hannagentai-stack/DoAn2_Traffic_Light_FPGA/docs/Danh_Sach_Chan_IO_FPGA_Cyclone_IV_Anode_Chung.docx

TRƯỜNG ĐẠI HỌC - KHOA ĐIỆN - ĐIỆN TỬ / BỘ MÔN KỸ THUẬT MÁY TÍNH

BẢNG TRA CỨU & DANH SÁCH GÁN CHÂN I/O PHẦN CỨNG FPGA

Phiên bản: ANODE CHUNG (Common Anode - 5621AH) - Kit Cyclone IV EP4CE6E22C8N & DE2-115

# 1. Thông Số Kỹ Thuật Bo Mạch FPGA Mục Tiêu

Dự án được thiết kế, tổng hợp và nạp thực tế trên bo mạch lõi FPGA giá rẻ phổ biến Altera / Intel Cyclone IV E EP4CE6E22C8N (kit lõi đen / Mini Core Board) và tương thích hoàn toàn về kiến trúc với dòng bo thí nghiệm Terasic DE2-115 (EP4CE115F29C7). Dưới đây là thông số phần cứng cốt lõi:

Thành Phần Phần Cứng | Thông Số / Mã Chip | Đặc Điểm Kỹ Thuật
Chip FPGA Chính | Altera / Intel Cyclone IV E EP4CE6E22C8N | Đóng gói QFP-144 chân, 6.272 Logic Elements, 392 Kbits RAM, 2 khối PLL.
Nguồn Cấp Hệ Thống | 5V DC qua cổng Type-C hoặc Header | Hạ áp bởi IC AMS1117 ra 3.3V (VCCIO cho các I/O Banks) và 1.2V (VCCINT cho lõi FPGA).
Xung Nhịp Master Clock | 50.000 MHz (Thạch anh tích hợp) | Nối vào chân PIN_24 (CLK0). Chu kỳ T = 20 ns, độ lệch pha ổn định < 0.1%.
Xung Nhịp Phụ (nếu có) | 27.000 MHz (Thạch anh thứ 2) | Nối vào chân PIN_90 / PIN_91 (dùng cho các ứng dụng Video/VGA nếu cần).
Bộ Nhớ Flash Nạp Code | EPCS4N / EPCS16 (SPI Flash) | Nối qua bus Active Serial (AS). Lưu file .jic để mạch chạy vĩnh viễn không mất code khi mất điện.
Giao Tiếp Nạp JTAG | Chuẩn Header 10-pin 2.54mm | Kết nối cáp USB-Blaster (TCK=16, TMS=18, TDO=20, TDI=17) nạp file .sof trực tiếp vào RAM.
Giao Tiếp UART / Serial | Chip USB-UART CH340 / Type-C | Nối sẵn vào chân PIN_10 (TXD) và PIN_23 (RXD), truyền dữ liệu lên máy tính PC.

# 2. Danh Sách Các Chân Cứng ONBOARD (Kiểm Chứng 100% Trên Bo)

Đây là danh sách toàn bộ các chân I/O đã được hàn cố định vào linh kiện trên bo mạch Cyclone IV EP4CE6E22C8N. Khi thiết kế mạch ngoài, cần nắm rõ để tránh xung đột phần cứng:

Chân FPGA | Linh Kiện Onboard | Chuẩn / Mức Logic | Ghi Chú & Kiểm Chứng Thực Tế
PIN_24 | Thạch anh 50 MHz | 3.3V LVTTL | In chữ '50M 24/25' trên PCB. Chân Clock toàn cục GCLK0. (PIN_25 là kênh dự phòng GCLK1).
PIN_1 | LED 1 Onboard (D1) | Active-Low (0 = Sáng) | In số '1' cạnh JTAG. Đã kiểm chứng sáng chớp tắt thành công.
PIN_2 | LED 2 Onboard (D2) | Active-Low (0 = Sáng) | In số '2' cạnh JTAG. Đã kiểm chứng sáng chớp tắt thành công.
PIN_3 | LED 3 Onboard (D3) | Active-Low (0 = Sáng) | In số '3' cạnh JTAG. Đã kiểm chứng sáng chớp tắt thành công.
PIN_7 | LED 4 Onboard (D4) | Active-Low (0 = Sáng) | In số '7' cạnh JTAG. Đã kiểm chứng sáng chớp tắt thành công.
PIN_11 | LED 5 Onboard (D5) | Active-Low (0 = Sáng) | In số '11' cạnh JTAG. Đã kiểm chứng sáng chớp tắt thành công.
PIN_88 | Nút Nhấn Reset | Active-Low (0 = Nhấn) | Nút bấm Reset hệ thống. Nối trở kéo lên 10k lên 3.3V trên bo.
PIN_73 | Nút Nhấn KEY 1 | Active-Low (0 = Nhấn) | In số '73' trên PCB cạnh hàng phím. Có thể dùng làm nút khẩn cấp A.
PIN_80 | Nút Nhấn KEY 2 | Active-Low (0 = Nhấn) | In số '80' trên PCB cạnh hàng phím. Có thể dùng làm nút khẩn cấp B.
PIN_89 | Nút Nhấn KEY 3 | Active-Low (0 = Nhấn) | In số '89' trên PCB. Có thể dùng làm công tắc chuyển chế độ.
PIN_114 | Nút Nhấn KEY 4 | Active-Low (0 = Nhấn) | In số '114' trên PCB. Nút nhấn người dùng đa năng.
PIN_23 | UART RX (Từ CH340) | 3.3V LVTTL | Nhận tín hiệu Serial từ máy tính qua cáp Type-C. KHÔNG ĐƯỢC DÙNG LÀM CLOCK!
PIN_10 | UART TX (Đến CH340) | 3.3V LVTTL | Truyền tín hiệu Serial từ FPGA lên máy tính qua cáp Type-C.
PIN_74 | Flash EPCS4N DATA0 | 3.3V LVTTL | Chân dữ liệu vào Flash SPI nạp vĩnh viễn.
PIN_75 | Flash EPCS4N DCLK | 3.3V LVTTL | Chân xung nhịp SPI cho Flash.
PIN_84 | Flash EPCS4N ASDI | 3.3V LVTTL | Chân dữ liệu ra Flash SPI.
PIN_87 | Flash EPCS4N nCS | 3.3V LVTTL | Chân chọn chip Flash Active-Low.

CẢNH BÁO QUAN TRỌNG VỀ XUNG CLOCK: Cực kỳ lưu ý rằng chân PIN_23 trên bo này được nối cố định với chip nạp UART CH340 (chân RX nhận dữ liệu từ USB), KHÔNG PHẢI là chân Clock 50MHz như một số bo kit Altera cũ khác. Chân thạch anh 50MHz chuẩn trên bo này bắt buộc phải là PIN_24 (CLK0)!

# 3. Bảng Gán Chân Chi Tiết Cho Dự Án Đèn Giao Thông (Top-Level Anode Chung)

Bảng dưới đây quy định toàn bộ 30 chân FPGA (gồm 1 chân Clock toàn cục 50MHz PIN_24 và 29 tín hiệu I/O ngoại vi) của thiết kế Top-Level (traffic_light_top.vhd) cho LED 7 đoạn Anode chung kèm IC đệm ULN2803A, kèm theo chân FPGA và vị trí cắm trên các hàng rào GPIO Header:

Tên Tín Hiệu (Port) | Hướng | Chân FPGA | Chuẩn Logic | Mức Kích Hoạt | Chức Năng & Vị Trí Kết Nối
CLOCK_50 | IN | PIN_24 | 3.3V LVTTL | Xung vuông | Thạch anh 50MHz tích hợp trên bo (GCLK0).
LEDG[0] | OUT | PIN_39 | 3.3V LVTTL | Active-High (1) | Đèn XANH Làn A (xanh_a trên Altium).
LEDR[0] | OUT | PIN_43 | 3.3V LVTTL | Active-High (1) | Đèn VÀNG Làn A (vang_a trên Altium).
LEDR[1] | OUT | PIN_46 | 3.3V LVTTL | Active-High (1) | Đèn ĐỎ Làn A (do_a trên Altium).
LEDG[1] | OUT | PIN_50 | 3.3V LVTTL | Active-High (1) | Đèn XANH Làn B (xanh_b trên Altium).
LEDR[2] | OUT | PIN_52 | 3.3V LVTTL | Active-High (1) | Đèn VÀNG Làn B (vang_b trên Altium).
LEDR[3] | OUT | PIN_54 | 3.3V LVTTL | Active-High (1) | Đèn ĐỎ Làn B (do_b trên Altium).
KEY[0] | IN | PIN_58 | 3.3V LVTTL | Active-Low (0) | Nút Reset toàn hệ thống (KEY0 trên Altium).
KEY[1] | IN | PIN_60 | 3.3V LVTTL | Active-Low (0) | Nút Khẩn cấp Làn A (KEY1 trên Altium).
KEY[2] | IN | PIN_65 | 3.3V LVTTL | Active-Low (0) | Nút Khẩn cấp Làn B (KEY2 trên Altium).
SW[0] | IN | PIN_67 | 3.3V LVTTL | Active-Low (0) | Chân 1 công tắc 3 nấc: Chế độ Ban đêm SW0 (Chớp vàng 1Hz).
SW[1] | IN | PIN_69 | 3.3V LVTTL | Active-Low (0) | Chân 3 công tắc 3 nấc: Chế độ Tạm dừng Pause SW1.
HEX_A_SEG[0] | OUT | PIN_129 | 3.3V LVTTL | Active-High (1) | Thanh đoạn a_a -> In 1B ULN2803A -> Qua trở R1 vào Chân 1 LED A.
HEX_A_SEG[1] | OUT | PIN_133 | 3.3V LVTTL | Active-High (1) | Thanh đoạn b_a -> In 2B ULN2803A -> Qua trở R2 vào Chân 2 LED A.
HEX_A_SEG[2] | OUT | PIN_136 | 3.3V LVTTL | Active-High (1) | Thanh đoạn c_a -> In 3B ULN2803A -> Qua trở R3 vào Chân 3 LED A.
HEX_A_SEG[3] | OUT | PIN_138 | 3.3V LVTTL | Active-High (1) | Thanh đoạn d_a -> In 4B ULN2803A -> Qua trở R4 vào Chân 4 LED A.
HEX_A_SEG[4] | OUT | PIN_142 | 3.3V LVTTL | Active-High (1) | Thanh đoạn e_a -> In 5B ULN2803A -> Qua trở R5 vào Chân 5 LED A.
HEX_A_SEG[5] | OUT | PIN_144 | 3.3V LVTTL | Active-High (1) | Thanh đoạn f_a -> In 6B ULN2803A -> Qua trở R6 vào Chân 6 LED A.
HEX_A_SEG[6] | OUT | PIN_143 | 3.3V LVTTL | Active-High (1) | Thanh đoạn g_a -> In 7B ULN2803A -> Qua trở R7 vào Chân 7 LED A.
HEX_A_DIG[0] | OUT | PIN_137 | 3.3V LVTTL | Active-High (1) | Chân chọn dig2_a (Đơn vị) -> Chân 9 Socket LED Làn A.
HEX_A_DIG[1] | OUT | PIN_141 | 3.3V LVTTL | Active-High (1) | Chân chọn dig1_a (Hàng chục) -> Chân 8 Socket LED Làn A.
HEX_B_SEG[0] | OUT | PIN_111 | 3.3V LVTTL | Active-High (1) | Thanh đoạn a_b -> In 1B ULN2803A -> Qua trở R8 vào Chân 1 LED B.
HEX_B_SEG[1] | OUT | PIN_113 | 3.3V LVTTL | Active-High (1) | Thanh đoạn b_b -> In 2B ULN2803A -> Qua trở R9 vào Chân 2 LED B.
HEX_B_SEG[2] | OUT | PIN_119 | 3.3V LVTTL | Active-High (1) | Thanh đoạn c_b -> In 3B ULN2803A -> Qua trở R10 vào Chân 3 LED B.
HEX_B_SEG[3] | OUT | PIN_121 | 3.3V LVTTL | Active-High (1) | Thanh đoạn d_b -> In 4B ULN2803A -> Qua trở R11 vào Chân 4 LED B.
HEX_B_SEG[4] | OUT | PIN_125 | 3.3V LVTTL | Active-High (1) | Thanh đoạn e_b -> In 5B ULN2803A -> Qua trở R12 vào Chân 5 LED B.
HEX_B_SEG[5] | OUT | PIN_127 | 3.3V LVTTL | Active-High (1) | Thanh đoạn f_b -> In 6B ULN2803A -> Qua trở R13 vào Chân 6 LED B.
HEX_B_SEG[6] | OUT | PIN_110 | 3.3V LVTTL | Active-High (1) | Thanh đoạn g_b -> In 7B ULN2803A -> Qua trở R14 vào Chân 7 LED B.
HEX_B_DIG[0] | OUT | PIN_112 | 3.3V LVTTL | Active-High (1) | Chân chọn dig2_b (Đơn vị) -> Chân 2 Socket LED Làn B.
HEX_B_DIG[1] | OUT | PIN_115 | 3.3V LVTTL | Active-High (1) | Chân chọn dig1_b (Hàng chục) -> Chân 1 Socket LED Làn B.

## 3.1. Bảng Hướng Dẫn Nối Dây Thực Tế Con LED 7 Đoạn Đôi 10 Chân Anode Chung Sang FPGA

Đây là bảng tra cứu trực tiếp theo thứ tự chân 1 đến 10 trên con LED 7 đoạn 2 chữ số Anode chung (5621AH / 3621AH, 10 chân) khi ghép nối với IC đệm dòng ULN2803G (DIP-18) để bảo vệ FPGA 100%:

SƠ ĐỒ BỐ TRÍ CHÂN THỰC TẾ (NHÌN TỪ MẶT TRƯỚC LED):
10 9 8 7 6
+--------------------------+
| A B D1 D2 F | <-- HÀNG CHÂN TRÊN
| |
| [DIG 1] [DIG 2] |
| (Hàng chục) (Đơn vị) |
| |
| C DP E D G | <-- HÀNG CHÂN DƯỚI
+--------------------------+
1 2 3 4 5

- IC ULN2803G đệm dòng cho 7 thanh đoạn: Chân FPGA phát mức '1' vào Input ULN2803G -> Output của ULN2803G kéo chân Cathode của thanh LED xuống GND -> LED SÁNG!
- 2 chân DIG1 (Chân 8) và DIG2 (Chân 7) là cực Dương chung (Anode), nối TRỰC TIẾP vào chân FPGA tương ứng (FPGA phát mức 1 cấp nguồn 3.3V).

Chân LED | Tên Đoạn | Nối Vào ULN2803G | Linh Kiện Kèm | FPGA Làn A | FPGA Làn B | Chức Năng & Vị Trí
Chân 1 | Thanh C | Out 3C (Chân 16) | Trở 330Ω | PIN_136 (In 3B) | PIN_119 (In 3B) | Thanh dọc dưới bên phải
Chân 2 | Dấu DP | Bỏ trống (Pin 11) | Không cắm | Để trống | Để trống | Dấu chấm lẻ (không dùng)
Chân 3 | Thanh E | Out 5C (Chân 14) | Trở 330Ω | PIN_142 (In 5B) | PIN_125 (In 5B) | Thanh dọc dưới bên trái
Chân 4 | Thanh D | Out 4C (Chân 15) | Trở 330Ω | PIN_138 (In 4B) | PIN_121 (In 4B) | Thanh ngang dưới đáy
Chân 5 | Thanh G | Out 7C (Chân 12) | Trở 330Ω | PIN_143 (In 7B) | PIN_110 (In 7B) | Thanh ngang ở chính giữa
Chân 6 | Thanh F | Out 6C (Chân 13) | Trở 330Ω | PIN_144 (In 6B) | PIN_127 (In 6B) | Thanh dọc trên bên trái
Chân 7 | DIG2 (Đơn vị) | Không qua ULN | Nối thẳng FPGA | PIN_137 | PIN_112 | Cực Dương chung Hàng đơn vị (3.3V)
Chân 8 | DIG1 (Chục) | Không qua ULN | Nối thẳng FPGA | PIN_141 | PIN_115 | Cực Dương chung Hàng chục (3.3V)
Chân 9 | Thanh B | Out 2C (Chân 17) | Trở 330Ω | PIN_133 (In 2B) | PIN_113 (In 2B) | Thanh dọc trên bên phải
Chân 10 | Thanh A | Out 1C (Chân 18) | Trở 330Ω | PIN_129 (In 1B) | PIN_111 (In 1B) | Thanh ngang trên đỉnh
ULN Pin 9 | GND IC ULN | Chân 9 (GND) | Dây nối GND | GND bo FPGA | GND bo FPGA | Cực Âm nguồn chung (BẮT BUỘC NỐI GND)
ULN Pin 10 | COM IC ULN | Chân 10 (COM) | Dây nối VCC | +3.3V / +5V | +3.3V / +5V | Chân diot dập xung (Nối lên nguồn 3.3V/5V)

## 3.2. Hướng Dẫn Chi Tiết Các Bước Cắm Dây Trên Breadboard (Board Test) Với IC UL2803G

Để cắm test mạch chạy mượt mà, không bị rối dây và đảm bảo an toàn tuyệt đối cho Kit FPGA Cyclone IV, bạn thực hiện cắm linh kiện trên Breadboard theo 4 bước chuẩn hóa sau:

BƯỚC 1: ĐẶT IC ULN2803A / ULN2803G VÀ CẤP NGUỒN
- Cắm 2 con IC ULN2803A (DIP-18) nằm ngang vắt qua rãnh giữa của Breadboard (IC1 cho Làn A, IC2 cho Làn B). Lưu ý khuyết tròn (chấm chỉ vị trí chân 1) quay sang phía bên tay trái.
- Chân 9 của cả 2 IC: Nối dây về thanh Bus GND (-) trên Breadboard, sau đó nối về chân GND của bo FPGA.
- Chân 10 của cả 2 IC: Nối dây về thanh Bus VCC (+) trên Breadboard, sau đó nối về chân 3.3V của bo FPGA.

BƯỚC 2: NỐI CHÂN TÍN HIỆU TỪ FPGA VÀO INPUT ULN2803A (Hàng chân dưới của IC: Chân 1 đến 7)
- Làn A: Nối 7 dây Đực-Đực từ FPGA vào Chân 1..7 của IC1 (khớp QSF HEX_A_SEG[0..6]):
+ PIN_129 -> Chân 1 (1B) | PIN_133 -> Chân 2 (2B) | PIN_136 -> Chân 3 (3B)
+ PIN_138 -> Chân 4 (4B) | PIN_142 -> Chân 5 (5B) | PIN_144 -> Chân 6 (6B) | PIN_143 -> Chân 7 (7B)
- Làn B: Nối 7 dây Đực-Đực từ FPGA vào Chân 1..7 của IC2 (khớp QSF HEX_B_SEG[0..6]):
+ PIN_111 -> Chân 1 (1B) | PIN_113 -> Chân 2 (2B) | PIN_119 -> Chân 3 (3B)
+ PIN_121 -> Chân 4 (4B) | PIN_125 -> Chân 5 (5B) | PIN_127 -> Chân 6 (6B) | PIN_110 -> Chân 7 (7B)

BƯỚC 3: NỐI OUTPUT ULN2803A QUA ĐIỆN TRỞ 330Ω VÀO CÁC ĐOẠN a..g CỦA LED 7 ĐOẠN (Hàng chân trên: Chân 18 về 12)
- Chân 18 (1C) -> Trở 330Ω -> Chân 10 của LED (Đoạn A)
- Chân 17 (2C) -> Trở 330Ω -> Chân 9 của LED (Đoạn B)
- Chân 16 (3C) -> Trở 330Ω -> Chân 1 của LED (Đoạn C)
- Chân 15 (4C) -> Trở 330Ω -> Chân 4 của LED (Đoạn D)
- Chân 14 (5C) -> Trở 330Ω -> Chân 3 của LED (Đoạn E)
- Chân 13 (6C) -> Trở 330Ω -> Chân 6 của LED (Đoạn F)
- Chân 12 (7C) -> Trở 330Ω -> Chân 5 của LED (Đoạn G)
- Chân 11 (8C) & Chân 2 của LED (DP): Bỏ trống không dùng.

BƯỚC 4: NỐI CHÂN ĐIỀU KHIỂN VỊ TRÍ DIG1, DIG2 (CỰC DƯƠNG CHUNG - ANODE 3.3V)
- Làn A: Nối thẳng PIN_141 vào Chân 8 của LED (DIG1 - Chục); Nối thẳng PIN_137 vào Chân 7 của LED (DIG2 - Đơn vị).
- Làn B: Nối thẳng PIN_115 vào Chân 8 của LED (DIG1 - Chục); Nối thẳng PIN_112 vào Chân 7 của LED (DIG2 - Đơn vị).
(Cách nối này không cần thêm transistor ngoài, cắm gọn gàng và chạy ngay lập tức).

TỐI ƯU CHO THIẾT KẾ LAYOUT MẠCH IN PCB: Các tín hiệu đã được phân bổ tối ưu theo nguyên tắc 'Zero-Crossing PCB Routing' (Không đan chéo đường mạch):
1. Hàng Rào Trên (Top Header): Dành riêng cho cụm Đèn giao thông và Điều khiển (PIN_39 đến PIN_69).
2. Hàng Rào Dưới (Bottom Header): Dành riêng cho 2 cụm LED 7 đoạn quét động Làn A & B (PIN_110 đến PIN_144).
3. Hàng Rào Trái (Left Header): Để trống 100%, không vướng vào cổng USB-C hay các nút bấm onboard.
Khi thiết kế Schematic và Layout trên Altium/KiCad/Proteus, các bus tín hiệu sẽ đi thẳng tắp ra linh kiện mà không cần đảo lớp hoặc dùng nhiều via xuyên lớp.

# 4. Danh Mục Toàn Bộ Các Chân GPIO Khả Dụng Trên Các Hàng Rào Cắm

Ngoài các chân đã sử dụng ở trên, bo mạch còn rất nhiều chân GPIO tự do mở rộng trên các hàng rào cắm. Người dùng có thể tự do chọn lựa các chân này để kết nối thêm cảm biến, còi báo động hoặc màn hình LCD:

Nhóm Vùng Chân | Danh Sách Chân FPGA (PIN_xx) | Đặc Tính & Khuyến Nghị
Hàng Rào Trên (Top Header) - Đang dùng | PIN_39, 43, 46, 50, 52, 54, 58, 60, 65, 67, 69 | Dùng cho 6 LED Giao thông (A, B) và 5 nút/công tắc điều khiển. 100% chân nằm hàng ngoài tối ưu Zero-Crossing.
Hàng Rào Trên (Top Header) - Dự phòng | PIN_70, PIN_71, PIN_72, PIN_73, PIN_74... | Các chân GPIO dự phòng tiếp theo trên rào trên, có thể nối thêm còi buzzer, đèn người đi bộ.
Hàng Rào Dưới (Bottom Header) - Đang dùng | PIN_110, 111, 112, 113, 115, 119, 121, 125, 127 (B) và PIN_129, 133, 136, 137, 138, 141, 142, 143, 144 (A) | Dùng toàn bộ cho 2 cụm LED 7 đoạn quét động Làn A & Làn B (18 chân kết nối qua ULN2803A và Anode).
Hàng Rào Dưới (Bottom Header) - Dự phòng | PIN_120, PIN_124, PIN_126, PIN_128, PIN_132, PIN_135 | Các chân dự phòng còn lại trên rào dưới.
Hàng Rào Trái (Left Header) - Để trống | PIN_28, PIN_30, PIN_31, PIN_32, PIN_33, PIN_34 | Để trống 100% để tránh vướng vào cổng USB-C và hàng nút nhấn onboard.
Chân Nguồn trên Rào | VCC3V3 (3.3V), VCC5V (5V), GND (0V) | Mỗi hàng rào đều có các chân GND và Nguồn để cấp cho module ngoài.

# 5. Danh Sách Các Chân CẤM HOẶC HẠN CHẾ Sử Dụng

Để tránh gây chập cháy phần cứng, mất kết nối JTAG hoặc hỏng chip FPGA, tuyệt đối KHÔNG được gán các tín hiệu người dùng vào các chân chuyên dụng dưới đây:

Nhóm Chức Năng | Chân FPGA | Lý Do Cấm / Cảnh Báo Rủi Ro
Giao Tiếp JTAG | PIN_16 (TCK), PIN_18 (TMS), PIN_20 (TDO), PIN_17 (TDI) | Phục vụ nạp chương trình từ máy tính. Nếu dùng làm I/O thường sẽ mất kết nối USB-Blaster và không thể nạp được chip.
Cấu Hình Hệ Thống | PIN_12 (nCONFIG), PIN_13 (nSTATUS), PIN_14 (CONF_DONE), PIN_15 (nCE) | Các chân điều khiển chu trình Boot của FPGA từ Flash. Nếu nối ngoại vi sẽ làm chip bị treo không khởi động.
Chế Độ Cấu Hình MSEL | MSEL[2..0] (Chân cấu hình phần cứng) | Quy định chế độ nạp (AS hay JTAG), đã được nối sẵn trở trên bo mạch.
Nguồn Lõi (VCCINT) | PIN_29, 45, 62, 82, 102, 118, 134... | Nguồn điện áp 1.2V cấp cho lõi logic bên trong FPGA. CẤM NỐI VÀO I/O!
Nguồn I/O (VCCIO) | PIN_26, 40, 56, 78, 93, 107, 122, 140... | Nguồn điện áp 3.3V cấp cho các khối đệm I/O. CẤM NỐI VÀO I/O!
Chân Mát (GND) | PIN_35, 47, 61, 79, 92, 108, 123, 139... | Nối đất toàn mạch (Ground). Tuyệt đối không gán logic.

# 6. Phụ Lục: Bảng Gán Chân Cho Kit DE2-115 (EP4CE115F29C7)

Bảng chân này dùng khi bạn cần đem đồ án lên phòng thực hành của trường để chạy trên kit Terasic DE2-115 (bo kit Altera Cyclone IV lớn hơn với 115.000 LEs và đầy đủ LED, Switch, 7 đoạn sẵn có):

Tín Hiệu (Port) | Chân DE2-115 | Điện Áp I/O | Linh Kiện Tích Hợp Sẵn Trên Kit
CLOCK_50 | PIN_Y2 | 3.3V LVTTL | Thạch anh 50MHz tích hợp trên DE2-115.
KEY[0] | PIN_M23 | 2.5 V | Nút bấm KEY0 trên bo (Master Reset).
KEY[1] | PIN_M21 | 2.5 V | Nút bấm KEY1 trên bo (Khẩn cấp Làn A).
KEY[2] | PIN_N21 | 2.5 V | Nút bấm KEY2 trên bo (Khẩn cấp Làn B).
SW[0] | PIN_AB28 | 2.5 V | Công tắc gạt SW0 trên bo (Chế độ Ban đêm).
SW[1] | PIN_AC28 | 2.5 V | Công tắc gạt SW1 trên bo (Chế độ Tạm dừng Pause).
LEDR[0] (Vàng A) | PIN_G19 | 2.5 V | Đèn LED đỏ/vàng LEDR0 trên bo.
LEDR[1] (Đỏ A) | PIN_F19 | 2.5 V | Đèn LED đỏ LEDR1 trên bo.
LEDG[0] (Xanh A) | PIN_E21 | 2.5 V | Đèn LED xanh lá LEDG0 trên bo.
LEDR[2] (Vàng B) | PIN_E19 | 2.5 V | Đèn LED đỏ/vàng LEDR2 trên bo.
LEDR[3] (Đỏ B) | PIN_F21 | 2.5 V | Đèn LED đỏ LEDR3 trên bo.
LEDG[1] (Xanh B) | PIN_E22 | 2.5 V | Đèn LED xanh lá LEDG1 trên bo.
HEX0[0..6] (Đơn vị A) | G18, F22, E17, L26, L25, J22, H22 | 2.5 V | LED 7 đoạn HEX0 sẵn trên bo (Active-Low).
HEX1[0..6] (Chục A) | M24, Y22, W21, W22, W25, U23, U24 | 2.5 V | LED 7 đoạn HEX1 sẵn trên bo (Active-Low).
HEX2[0..6] (Đơn vị B) | AA25, AA26, Y25, W26, Y27, W27, W28 | 2.5 V | LED 7 đoạn HEX2 sẵn trên bo (Active-Low).
HEX3[0..6] (Chục B) | V21, U21, AB20, AA21, AD24, AF23, Q25 | 2.5 V | LED 7 đoạn HEX3 sẵn trên bo (Active-Low).

# 7. Đoạn Mã Lệnh TCL Gán Chân Mẫu Để Chèn Vào File .QSF (Quartus)

Nếu bạn muốn áp dụng ngay bảng gán chân này cho bo Cyclone IV EP4CE6E22C8N, chỉ cần sao chép toàn bộ đoạn mã dưới đây và dán vào cuối file traffic_light_top.qsf:

# ==============================================================================
# PIN ASSIGNMENTS - DONG BO CHUAN 100% THEO ALTIUM DESIGNER & QUARTUS (.QSF)
# Kit Altera / Intel Cyclone IV E EP4CE6E22C8N (Dien ap chuan: 3.3-V LVTTL)
# ==============================================================================
# 1. MASTER CLOCK 50 MHZ (ONBOARD CRYSTAL OSCILLATOR)
set_location_assignment PIN_24 -to CLOCK_50
set_instance_assignment -name IO_STANDARD "3.3-V LVTTL" -to CLOCK_50

# 2. CỤM ĐÈN GIAO THÔNG LÀN A (Active-High: '1' là sáng đèn)
set_location_assignment PIN_39 -to LEDG[0]
set_location_assignment PIN_43 -to LEDR[0]
set_location_assignment PIN_46 -to LEDR[1]
set_instance_assignment -name IO_STANDARD "3.3-V LVTTL" -to LEDG[0]
set_instance_assignment -name IO_STANDARD "3.3-V LVTTL" -to LEDR[0]
set_instance_assignment -name IO_STANDARD "3.3-V LVTTL" -to LEDR[1]

# 3. CỤM ĐÈN GIAO THÔNG LÀN B (Active-High: '1' là sáng đèn)
set_location_assignment PIN_50 -to LEDG[1]
set_location_assignment PIN_52 -to LEDR[2]
set_location_assignment PIN_54 -to LEDR[3]
set_instance_assignment -name IO_STANDARD "3.3-V LVTTL" -to LEDG[1]
set_instance_assignment -name IO_STANDARD "3.3-V LVTTL" -to LEDR[2]
set_instance_assignment -name IO_STANDARD "3.3-V LVTTL" -to LEDR[3]

# 4. NGÕ VÀO ĐIỀU KHIỂN: NÚT BẤM & CÔNG TẮC (Active-Low kèm Weak Pull-up)
set_location_assignment PIN_58 -to KEY[0]
set_location_assignment PIN_60 -to KEY[1]
set_location_assignment PIN_65 -to KEY[2]
set_location_assignment PIN_67 -to SW[0]
set_location_assignment PIN_69 -to SW[1]
set_instance_assignment -name IO_STANDARD "3.3-V LVTTL" -to KEY[*]
set_instance_assignment -name WEAK_PULL_UP_RESISTOR ON -to KEY[*]
set_instance_assignment -name IO_STANDARD "3.3-V LVTTL" -to SW[*]
set_instance_assignment -name WEAK_PULL_UP_RESISTOR ON -to SW[*]

# 5. CẶP LED 7 ĐOẠN ĐÔI LÀN A (Anode Chung qua Đệm ULN2803A)
# Segments a..g: a=129, b=133, c=136, d=138, e=142, f=144, g=143
set_location_assignment PIN_129 -to HEX_A_SEG[0]
set_location_assignment PIN_133 -to HEX_A_SEG[1]
set_location_assignment PIN_136 -to HEX_A_SEG[2]
set_location_assignment PIN_138 -to HEX_A_SEG[3]
set_location_assignment PIN_142 -to HEX_A_SEG[4]
set_location_assignment PIN_144 -to HEX_A_SEG[5]
set_location_assignment PIN_143 -to HEX_A_SEG[6]
set_instance_assignment -name IO_STANDARD "3.3-V LVTTL" -to HEX_A_SEG[*]

# Digits: dig2_a (Don vi) = PIN_137, dig1_a (Chuc) = PIN_141
set_location_assignment PIN_137 -to HEX_A_DIG[0]
set_location_assignment PIN_141 -to HEX_A_DIG[1]
set_instance_assignment -name IO_STANDARD "3.3-V LVTTL" -to HEX_A_DIG[*]

# 6. CẶP LED 7 ĐOẠN ĐÔI LÀN B (Anode Chung qua Đệm ULN2803A)
# Segments a..g: a=111, b=113, c=119, d=121, e=125, f=127, g=110
set_location_assignment PIN_111 -to HEX_B_SEG[0]
set_location_assignment PIN_113 -to HEX_B_SEG[1]
set_location_assignment PIN_119 -to HEX_B_SEG[2]
set_location_assignment PIN_121 -to HEX_B_SEG[3]
set_location_assignment PIN_125 -to HEX_B_SEG[4]
set_location_assignment PIN_127 -to HEX_B_SEG[5]
set_location_assignment PIN_110 -to HEX_B_SEG[6]
set_instance_assignment -name IO_STANDARD "3.3-V LVTTL" -to HEX_B_SEG[*]

# Digits: dig2_b (Don vi) = PIN_112, dig1_b (Chuc) = PIN_115
set_location_assignment PIN_112 -to HEX_B_DIG[0]
set_location_assignment PIN_115 -to HEX_B_DIG[1]
set_instance_assignment -name IO_STANDARD "3.3-V LVTTL" -to HEX_B_DIG[*]
