hannagentai-stack/DoAn2_Traffic_Light_FPGA/docs/Danh_Sach_Linh_Kien_Do_An_Traffic_Light_Anode_Chung.docx

TRƯỜNG ĐẠI HỌC - KHOA ĐIỆN - ĐIỆN TỬ / BỘ MÔN KỸ THUẬT MÁY TÍNH

BẢNG TỔNG HỢP LINH KIỆN & DỰ TOÁN MUA SẮM (BOM)

Phiên bản: ANODE CHUNG (Common Anode - 5621AH) - Kit FPGA Cyclone IV EP4CE6E22C8N

# 1. Bảng Thống Kê Chi Tiết Linh Kiện Cần Mua (Phiên Bản Anode Chung)

Hệ thống sử dụng LED 7 đoạn đôi ANODE CHUNG (Cực Dương chung - mã đuôi AH). Bảng dưới đây thống kê toàn bộ linh kiện cần thiết cho cả 2 phương án: cắm test nhanh trực tiếp trên Breadboard hoặc làm mạch in PCB hoàn chỉnh:

STT | Tên Linh Kiện | Mã / Thông Số Kỹ Thuật | Cần | Nên Mua | Công Dụng & Vị Trí Trong Mạch | Đơn Giá Ước Tính
1 | LED 7 đoạn 2 số 0.56" Anode chung | 5621AH / 3621AH / 5622AH (10 chân) | 2 con | 3 con | Đồng hồ đếm lùi 2 chữ số (1 con Làn A, 1 con Làn B). Mã có chữ cái A là Anode chung | 8.000 đ
2 | LED đơn 5mm Màu ĐỎ (Red) | Siêu sáng / Đục 5mm | 2 con | 5 con | Đèn ĐỎ Làn A (PIN_46) và Làn B (PIN_54) | 500 đ
3 | LED đơn 5mm Màu VÀNG (Yellow) | Siêu sáng / Đục 5mm | 2 con | 5 con | Đèn VÀNG Làn A (PIN_43) và Làn B (PIN_52) | 500 đ
4 | LED đơn 5mm Màu XANH LÁ (Green) | Siêu sáng / Đục 5mm | 2 con | 5 con | Đèn XANH Làn A (PIN_39) và Làn B (PIN_50) | 500 đ
5 | IC Đệm dòng 8 kênh Darlington | ULN2803A / ULN2803G (DIP-18) | 2 con | 3 con | Đệm kéo 14 thanh đoạn a..g xuống GND (1 con Làn A, 1 con Làn B), bảo vệ tuyệt đối cổng I/O FPGA | 4.000 đ
6 | Đế cắm IC 18 chân | DIP-18 IC Socket | 2 cái | 4 cái | Hàn lên PCB hoặc cắm lên Breadboard để cắm rút IC ULN2803A | 500 đ
7 | Điện trở 330 Ω (hoặc 220 Ω) | 1/4W (Trở cắm 5 vạch màu) | 20 con | 1 gói (50 con) | Hạn dòng bảo vệ cho 6 đèn LED giao thông và 14 thanh LED 7 đoạn a..g | 3.000 đ/gói
8 | Điện trở 10k Ω (Kéo lên dự phòng) | 1/4W | 5 con | 10 con | Trở kéo lên dự phòng ngoài cho nút nhấn / công tắc (FPGA đã bật Weak Pull-up nội) | 1.000 đ
9 | Nút nhấn nhả 4 chân (Tactile switch) | 6x6x5mm | 3 nút | 5 nút | Nút Reset (PIN_58), Khẩn cấp Làn A (PIN_60), Khẩn cấp Làn B (PIN_65) | 500 đ
10 | Công tắc cần gạt 3 vị trí ON-OFF-ON | MTS-103 (3 chân) hoặc MTS-203 (6 chân) | 1 cái | 2 cái | Tích hợp 3 chế độ: Gạt trái = Ban đêm (PIN_67), Giữa = Tự động bình thường, Gạt phải = Tạm dừng (PIN_69) | 4.000 đ
11 | Breadboard MB-102 (Bo cắm test) | 830 lỗ (165 x 55 mm) | 1 bo | 1 - 2 bo | Cắm linh kiện chạy thử nghiệm trước khi hàn mạch in PCB | 25.000 đ
12 | Dây cắm Breadboard Đực - Cái | Male to Female 20cm | 1 tép | 1 tép (40 sợi) | Nối từ hàng cọc kim của bo FPGA sang Breadboard | 15.000 đ
13 | Dây cắm Breadboard Đực - Đực | Male to Male 10cm / 20cm | 1 tép | 1 tép (40 sợi) | Cầu dây nối các linh kiện trên mặt Breadboard | 15.000 đ
14 | Rào Cái 2.54mm 2 hàng (Nữ) | Female Header 2x20 pin | 2 thanh | 4 thanh | Hàn lên bo mạch PCB để cắm bo mạch FPGA Cyclone IV lên | 3.000 đ

NGUYÊN LÝ ĐIỀU KHIỂN & ĐỆM DÒNG ULN2803A: HƯỚNG DẪN ĐẤU NỐI VỚI IC ĐỆM ULN2803A VÀ LED ANODE CHUNG: Khi cắm mạch với LED 7 đoạn Anode chung, chân FPGA phát mức 1 (+3.3V) cấp nguồn cho DIG1/DIG2 (Anode) và phát mức 1 (Active-High) kích ngõ vào IC đệm dòng ULN2803A. Khi nhận mức 1, IC đệm ULN2803A kéo ngõ ra tương ứng xuống Mass (GND) để làm sáng thanh đoạn LED qua điện trở hạn dòng 330Ω, giúp bảo vệ an toàn 100% cho chip FPGA!

# 2. Sơ Đồ Chân Thực Tế LED 7 Đoạn Đôi 10 Chân Anode Chung (5621AH / 3621AH)

Sơ đồ 10 chân chuẩn Type-B đã được kiểm chứng hoạt động chính xác 100% trên phần cứng thực tế:
- Hàng chân DƯỚI (tính từ Trái qua Phải: 1 đến 5): Chân 1 (C), 2 (DP), 3 (E), 4 (D), 5 (G).
- Hàng chân TRÊN (tính từ Phải qua Trái: 10 về 6): Chân 10 (A), 9 (B), 8 (DIG1 Chục), 7 (DIG2 Đơn vị), 6 (F).

Chân LED | Tên Đoạn | Linh Kiện Mắc Kèm | FPGA Làn A | FPGA Làn B | Chức Năng & Vị Trí Nét
Chân 10 | Thanh A | Trở 330Ω qua ULN (1B/1C) | PIN_129 | PIN_111 | Thanh ngang trên đỉnh (Mức 1 FPGA kích sáng)
Chân 9 | Thanh B | Trở 330Ω qua ULN (2B/2C) | PIN_133 | PIN_113 | Thanh dọc trên bên phải (Mức 1 FPGA kích sáng)
Chân 1 | Thanh C | Trở 330Ω qua ULN (3B/3C) | PIN_136 | PIN_119 | Thanh dọc dưới bên phải (Mức 1 FPGA kích sáng)
Chân 4 | Thanh D | Trở 330Ω qua ULN (4B/4C) | PIN_138 | PIN_121 | Thanh ngang dưới đáy (Mức 1 FPGA kích sáng)
Chân 3 | Thanh E | Trở 330Ω qua ULN (5B/5C) | PIN_142 | PIN_125 | Thanh dọc dưới bên trái (Mức 1 FPGA kích sáng)
Chân 6 | Thanh F | Trở 330Ω qua ULN (6B/6C) | PIN_144 | PIN_127 | Thanh dọc trên bên trái (Mức 1 FPGA kích sáng)
Chân 5 | Thanh G | Trở 330Ω qua ULN (7B/7C) | PIN_143 | PIN_110 | Thanh ngang ở chính giữa (Mức 1 FPGA kích sáng)
Chân 2 | Dấu DP | Không cắm | Để trống | Để trống | Dấu chấm lẻ (không dùng)
Chân 8 | DIG1 (Chục) | Nối thẳng FPGA | PIN_141 | PIN_115 | Cực Dương chung Hàng chục (Mức 1 cấp 3.3V)
Chân 7 | DIG2 (Đơn vị) | Nối thẳng FPGA | PIN_137 | PIN_112 | Cực Dương chung Hàng đơn vị (Mức 1 cấp 3.3V)

# 3. Bảng Tổng Hợp 30 Chân Tín Hiệu FPGA Hệ Thống (Zero-Crossing)

Hệ thống sử dụng tổng cộng 30 chân FPGA bao gồm 1 chân xung nhịp Clock 50MHz và 29 chân I/O ngoại vi được phân bổ đều đặn trên các hàng rào cắm theo nguyên tắc Zero-Crossing giúp layout mạch in PCB không bị đan chéo:

Nhóm Chức Năng | Số Chân | Danh Sách Chân FPGA | Vị Trí Hàng Rào Cắm
Xung Nhịp Master Clock 50MHz | 1 chân | PIN_24 (CLK0 / GCLK0) | Chân Clock Toàn Cục Onboard
Đèn Giao Thông Làn A (Xanh, Vàng, Đỏ) | 3 chân | PIN_39, PIN_43, PIN_46 | Rào Cắm Trên (Top Header)
Đèn Giao Thông Làn B (Xanh, Vàng, Đỏ) | 3 chân | PIN_50, PIN_52, PIN_54 | Rào Cắm Trên (Top Header)
Nút Nhấn Điều Khiển (Reset, Khẩn cấp A, B) | 3 chân | PIN_58, PIN_60, PIN_65 | Rào Cắm Trên (Top Header)
Công Tắc Gạt (Ban đêm, Tạm dừng Pause) | 2 chân | PIN_67, PIN_69 | Rào Cắm Trên (Top Header)
LED 7 Đoạn Làn A (7 đoạn a..g + 2 digit) | 9 chân | PIN_129..144 (a..g) và PIN_137, 141 | Rào Cắm Dưới (Bottom Header)
LED 7 Đoạn Làn B (7 đoạn a..g + 2 digit) | 9 chân | PIN_110..127 (a..g) và PIN_112, 115 | Rào Cắm Dưới (Bottom Header)
Tổng Cộng Chân FPGA Sử Dụng | 30 chân | 1 Clock onboard + 11 chân Rào Trên + 18 chân Rào Dưới | Rào Trái để trống 100%
