hannagentai-stack/DoAn2_Traffic_Light_FPGA/docs/Bao_Cao_Giai_Thich_Code_Va_Nguyen_Ly_Module.docx

BÁO CÁO KỸ THUẬT CHUYÊN ĐỀ VHDL
GIẢI THÍCH MÃ NGUỒN VHDL & NGUYÊN LÝ HOẠT ĐỘNG CÁC MODULE
HỆ THỐNG ĐIỀU KHIỂN ĐÈN GIAO THÔNG NGÃ TƯ TRÊN FPGA CYCLONE IV

Đối tượng chip: Altera / Intel Cyclone IV E (EP4CE6E22C8N)
Công cụ thiết kế: Quartus Prime Lite 20.1 & Trình mô phỏng ModelSim / QuestaSim
Tài liệu bao gồm: Thuyết minh kiến trúc, Giải thích chi tiết mã nguồn từng dòng,
và Khung tiêu chuẩn tích hợp để chèn ảnh dạng sóng mô phỏng thực tế.

# PHẦN 1: TỔNG QUAN KIẾN TRÚC PHẦN CỨNG VÀ SƠ ĐỒ GHÉP NỐI TOÀN CỤC

Hệ thống điều khiển đèn giao thông ngã tư được thiết kế theo phương pháp phân rã cấu trúc phân tầng (Hierarchical Structural Modeling). Toàn bộ hệ thống được chia thành 4 khối chức năng con độc lập và được ghép nối tại module đỉnh (traffic_light_top.vhd):
1. Khối clk_divider: Bộ chia tần số số học 32-bit hạ xung thạch anh 50 MHz xuống nhịp đếm 1 Hz (tick 1s) và nhịp chớp vàng 1 Hz (duty 50%).
2. Khối fsm_controller: Máy trạng thái hữu hạn Moore 6 trạng thái điều phối thứ tự 4 pha đèn, chế độ ban đêm và các ngắt ưu tiên khẩn cấp.
3. Khối timer_counter: Bộ đếm lùi thời gian đồng bộ và bộ chuyển đổi tách số BCD (hàng chục và hàng đơn vị) bằng chuỗi so sánh trừ tối ưu.
4. Khối seg7_decoder: Mạch logic tổ hợp giải mã mã BCD 4-bit sang tín hiệu 7 đoạn Active-Low (a..g) điều khiển LED 7 đoạn hiển thị thời gian.
5. Mạch khóa an toàn phần cứng (Fail-safe Hardware Interlock): Mạch tổ hợp độc lập giám sát ngõ ra, tự động ngắt 2 đèn xanh và ép bật 2 đèn đỏ nếu phát hiện lỗi đồng thời.

📷 [ KHUNG CHỜ DÀNH CHO BẠN CHÈN ẢNH SÓNG MÔ PHỎNG VÀO ĐÂY ]
(Hướng dẫn: Chụp ảnh cửa sổ Wave trên ModelSim -> Click chuột vào ô này -> Nhấn Ctrl + V để dán ảnh)

Hình 1.1: Sơ đồ khối kiến trúc phần cứng RTL toàn cục trích xuất từ Quartus RTL Viewer

• Điểm cần quan sát trên dạng sóng: Quan sát các cổng vào/ra (CLOCK_50, KEY, SW, LEDR, LEDG, HEX) và các đường bus nối giữa 4 khối con clk_divider, fsm_controller, timer_counter và seg7_decoder.

# PHẦN 2: NGUYÊN LÝ HOẠT ĐỘNG & GIẢI THÍCH CHI TIẾT MÃ NGUỒN CÁC MODULE

## 2.1. Module clk_divider.vhd (Bộ chia tần số & Tạo nhịp chuẩn)

• Nguyên lý hoạt động:
Nguồn xung nhịp thạch anh tích hợp trên kit Cyclone IV có tần số f = 50 MHz (chu kỳ T = 20 ns). Bộ đếm số nguyên thanh_ghi_dem đếm từ 0 đến 49.999.999 (đủ 50 triệu xung clock = 1 giây thực tế). Thay vì tạo ra một xung clock mới gây lệch pha (Clock Skew), module phát ra tín hiệu xung_tick_1hz có độ rộng đúng 1 chu kỳ clock (20 ns) để làm tín hiệu cho phép (Clock Enable) cho khối Timer. Đồng thời, tín hiệu xung_chop_1hz được duy trì mức '1' ở 25 triệu xung đầu và mức '0' ở 25 triệu xung sau, tạo xung vuông đối xứng 50% duty cycle.

• Giải thích các đoạn mã nguồn then chốt:

-- Dinh nghia nguong dem theo Generic SIMULATION:

constant CHU_KY_DAY_PHAN_CUNG : natural := 50000000; -- 50 trieu xung = 1 giay tren chip that

constant CHU_KY_DAY_MO_PHONG : natural := 50; -- Thu nho con 50 xung khi chay ModelSim

-- Qua trinh dem va phat xung tick 1 giay:

if thanh_ghi_dem = GIOI_HAN_DEM - 1 then

thanh_ghi_dem <= 0; -- Reset bo dem ve 0

thanh_ghi_tick <= '1'; -- Phat xung tick len 1 dung 1 chu ky clock

thanh_ghi_chop <= '1'; -- Keo xung chop len 1

elsif thanh_ghi_dem = GIOI_HAN_NUA_DEM - 1 then

thanh_ghi_dem <= thanh_ghi_dem + 1;

thanh_ghi_tick <= '0';

thanh_ghi_chop <= '0'; -- Ha xung chop ve 0 tao duty cycle 50%

else

thanh_ghi_dem <= thanh_ghi_dem + 1;

thanh_ghi_tick <= '0';

end if;

📷 [ KHUNG CHỜ DÀNH CHO BẠN CHÈN ẢNH SÓNG MÔ PHỎNG VÀO ĐÂY ]
(Hướng dẫn: Chụp ảnh cửa sổ Wave trên ModelSim -> Click chuột vào ô này -> Nhấn Ctrl + V để dán ảnh)

Hình 2.1: Dạng sóng mô phỏng xung kích tick_1hz và xung chớp blink_1hz trên ModelSim

• Điểm cần quan sát trên dạng sóng: Xung tick_1hz chỉ vọt lên mức cao '1' trong đúng 1 chu kỳ xung clock 50MHz khi chạm ngưỡng đếm, và xung_chop_1hz đảo trạng thái tuần hoàn đối xứng.

## 2.2. Module fsm_controller.vhd (Khối điều khiển Máy trạng thái FSM Moore)

• Nguyên lý hoạt động:
Máy trạng thái FSM đóng vai trò bộ não điều phối giao thông, được thiết kế theo mô hình Moore 3 tiến trình (3-Process FSM):
- Process 1 (Thanh ghi trạng thái): Cập nhật trang_thai_hien_tai <= trang_thai_ke_tiep theo sườn dương clock 50 MHz.
- Process 2 (Logic chuyển trạng thái): Xét duyệt thứ tự ưu tiên các tín hiệu ngoại vi (Khẩn cấp Làn A > Khẩn cấp Làn B > Ban đêm > Tạm dừng > Hết giờ co_het_gio).
- Process 3 (Logic ngõ ra Moore): Tín hiệu điều khiển đèn chỉ phụ thuộc duy nhất vào trang_thai_hien_tai, triệt tiêu hoàn toàn xung nhiễu (glitches).
- Cờ nap_pha: Phát ra một xung mức '1' rộng 1 chu kỳ clock khi trang_thai_hien_tai /= trang_thai_truoc_do để báo Timer nạp số giây mới.

• Giải thích các đoạn mã nguồn then chốt:

-- Khai bao kieu liet ke 6 trang thai cua FSM:

type kieu_trang_thai is (PHA_1, PHA_2, PHA_3, PHA_4, BAN_DEM, KHAN_CAP);

-- Mach phat xung nap thoi gian khi co su kien doi pha:

nap_pha <= '1' when (trang_thai_hien_tai /= trang_thai_truoc_do) else '0';

-- Phan cap thu tu uu tien trong Process chuyen trang thai:

if key_khan_cap_a_n = '0' then

trang_thai_ke_tiep <= KHAN_CAP; -- Uu tien cao nhat: Xe cuu thuong Lan A

elsif key_khan_cap_b_n = '0' and sw_ban_dem = '0' and ... then

trang_thai_ke_tiep <= PHA_3; -- Uu tien nhi: Nhay sang Pha 3 cho Lan B

elsif sw_ban_dem = '1' then

trang_thai_ke_tiep <= BAN_DEM; -- Uu tien ba: Che do ban dem

elsif sw_tam_dung = '1' then

trang_thai_ke_tiep <= trang_thai_hien_tai; -- Tam dung giu nguyen

else

-- Chuyen pha tuan tu khi co tin hieu co_het_gio = '1':

case trang_thai_hien_tai is

when PHA_1 => if co_het_gio = '1' then trang_thai_ke_tiep <= PHA_2; end if;

when PHA_2 => if co_het_gio = '1' then trang_thai_ke_tiep <= PHA_3; end if;

when PHA_3 => if co_het_gio = '1' then trang_thai_ke_tiep <= PHA_4; end if;

when PHA_4 => if co_het_gio = '1' then trang_thai_ke_tiep <= PHA_1; end if;

when others => trang_thai_ke_tiep <= PHA_1;

end case;

end if;

📷 [ KHUNG CHỜ DÀNH CHO BẠN CHÈN ẢNH SÓNG MÔ PHỎNG VÀO ĐÂY ]
(Hướng dẫn: Chụp ảnh cửa sổ Wave trên ModelSim -> Click chuột vào ô này -> Nhấn Ctrl + V để dán ảnh)

Hình 2.2: Dạng sóng mô phỏng chuyển trạng thái FSM (Pha 1 -> 2 -> 3 -> 4) và các chế độ ưu tiên trên ModelSim

• Điểm cần quan sát trên dạng sóng: Sự chuyển dịch của biến trang_thai_hien_tai, xung nap_pha nhô lên '1' đúng 1 chu kỳ tại biên đổi trạng thái, và các đèn den_xanh_a, den_vang_a, den_do_b bật tắt chuẩn xác.

## 2.3. Module timer_counter.vhd (Bộ đếm lùi thời gian & Tách BCD tối ưu)

• Nguyên lý hoạt động:
Bộ đếm quản lý thời gian đếm lùi của cả 2 làn A và B (dem_lan_a, dem_lan_b) có độ rộng 6-bit (từ 0 đến 63 giây). Mỗi khi nhận xung nap_pha = '1', mạch tự động nạp các giá trị đặt trước tương ứng: Pha 1 nạp 25s/28s, Pha 2 nạp 3s/3s, Pha 3 nạp 33s/30s, Pha 4 nạp 3s/3s. Khi có xung_tick_1hz và không bị bật công tắc tam_dung, bộ đếm giảm 1 đơn vị. Khi bộ đếm chạm mốc 1 giây, co_het_gio được kích lên '1' để FSM chuyển pha ở giây kế tiếp.

• Giải thuật tách số BCD tối ưu phần cứng (Hardware-friendly BCD Conversion):
Trên FPGA, phép chia (/) và chia lấy dư (mod) tiêu tốn rất nhiều tài nguyên Logic Elements và có đường trễ tổ hợp rất dài. Thủ tục chuyen_sang_bcd sử dụng chuỗi so sánh trừ tuần tự (>= 30, >= 20, >= 10), giúp Quartus tổng hợp thành các bộ trừ nhị phân nhỏ gọn, tốc độ tức thì và tiết kiệm tối đa diện tích chip.

• Giải thích đoạn mã nguồn then chốt:

-- Thu tuc chuyen doi sang BCD hang chuc va hang don vi bang so sanh tru:

procedure chuyen_sang_bcd(gia_tri_vao : in natural range 0 to 63; ...) is

begin

if gia_tri_vao >= 30 then

chuc_ra := "0011"; -- Hang chuc la 3

don_vi_ra := std_logic_vector(to_unsigned(gia_tri_vao - 30, 4));

elsif gia_tri_vao >= 20 then

chuc_ra := "0010"; -- Hang chuc la 2

don_vi_ra := std_logic_vector(to_unsigned(gia_tri_vao - 20, 4));

elsif gia_tri_vao >= 10 then

chuc_ra := "0001"; -- Hang chuc la 1

don_vi_ra := std_logic_vector(to_unsigned(gia_tri_vao - 10, 4));

else

chuc_ra := "0000"; -- Hang chuc la 0

don_vi_ra := std_logic_vector(to_unsigned(gia_tri_vao, 4));

end if;

end procedure;

-- Kich hoat co bao het gio khi dem ve moc 1 giay:

if dem_lan_a = 1 then

thanh_ghi_het_gio <= '1'; -- Bao cho FSM biet se chuyen pha o chu ky clock tiep theo

end if;

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

Hình 2.3: Dạng sóng mô phỏng bộ đếm lùi dem_lan_a, dem_lan_b và các bus BCD hàng chục/đơn vị trên ModelSim

• Điểm cần quan sát trên dạng sóng: Quan sát biến dem_lan_a giảm từng đơn vị theo nhịp xung_tick_1hz, tín hiệu co_het_gio bật lên '1' khi đếm về 1, và các bus BCD chuyển đổi mượt mà.

## 2.4. Module seg7_decoder.vhd & traffic_light_top.vhd (Giải mã 7 đoạn & Quét MUX 1 kHz)

• Module seg7_decoder.vhd: Chuyển đổi mã BCD 4-bit sang 7 đoạn theo chuẩn Active-Low (mức 0 là thanh LED sáng, mức 1 là tắt). Tích hợp ngõ vào tat_led (Blanking) để ngắt toàn bộ thanh LED về '1111111' khi chuyển sang chế độ ban đêm nhằm tiết kiệm điện năng.

• Kỹ thuật quét hiển thị đa kênh Dynamic Scanning 1 kHz trong traffic_light_top.vhd:
Bộ đếm bo_dem_quet đếm 50.000 chu kỳ clock 50 MHz (tương đương 1 ms) rồi đảo trạng thái chon_vi_tri_led. Khi chon_vi_tri_led = '0', bus BCD hàng đơn vị được đưa vào IC giải mã và chân DIG(0) được kích hoạt. Khi chon_vi_tri_led = '1', bus BCD hàng chục được đưa vào và chân DIG(1) được kích hoạt. Nhờ hiện tượng lưu ảnh của mắt người (> 24 Hz), mắt quan sát thấy cả 2 chữ số đều sáng liên tục mà chỉ tiêu tốn 7 chân dữ liệu thay vì 14 chân.

• Mạch khóa an toàn phần cứng (Fail-safe Hardware Interlock):
Ở khối cuối cùng của module Top, nếu có bất kỳ sự cố nào làm cả den_xanh_a_s và den_xanh_b_s cùng lên '1', phần cứng tự động can thiệp ép ngắt cả 2 đèn xanh về '0' và bật cả 2 đèn đỏ lên '1', ngăn ngừa tai nạn giao thông.

-- Mach quet Dynamic Multiplexing 1 kHz:

process(CLOCK_50, KEY(0))

begin

if KEY(0) = '0' then

bo_dem_quet <= 0;

chon_vi_tri_led <= '0';

elsif rising_edge(CLOCK_50) then

if bo_dem_quet = 49999 then

bo_dem_quet <= 0;

chon_vi_tri_led <= not chon_vi_tri_led; -- Dao vi tri Quet

else

bo_dem_quet <= bo_dem_quet + 1;

end if;

end if;

end process;

-- Mach khoa an toan phan cung Fail-safe Interlock:

if (den_xanh_a_s = '1' and den_xanh_b_s = '1') then

LEDG(0) <= '0'; LEDG(1) <= '0'; -- Ep ngat 2 den xanh

LEDR(1) <= '1'; LEDR(3) <= '1'; -- Ep bat 2 den do

else

LEDG(0) <= den_xanh_a_s; ...

end if;

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

Hình 2.4: Dạng sóng mô phỏng quét hiển thị đa kênh LED 7 đoạn (chon_vi_tri_led) và ngõ ra đèn giao thông

• Điểm cần quan sát trên dạng sóng: Tín hiệu chon_vi_tri_led đảo nhịp luân phiên giữa 0 và 1, ngõ ra HEX_A_SEG thay đổi tương ứng giữa hàng chục và đơn vị.

# PHẦN 3: KỊCH BẢN MÔ PHỎNG & ĐO ĐẠC TRÊN TESTBENCH (tb_traffic_light_top.vhd)

Module tb_traffic_light_top.vhd là testbench mô phỏng toàn diện không có cổng vật lý. Kịch bản kiểm thử tự động trải qua 7 giai đoạn liên tiếp:
• Giai đoạn 1: Kích hoạt xung Reset hệ thống kéo tin_hieu_key(0) xuống mức '0' trong 100 ns.
• Giai đoạn 2 & 3: Kiểm tra chuyển đổi 4 pha đèn thông thường qua 2 chu kỳ hoàn chỉnh, tự động đo thời lượng từng pha bằng biến thoi_luong_pha = now - thoi_diem_bat_dau_pha.
• Giai đoạn 4: Bật công tắc tin_hieu_sw(0) = '1' kiểm tra chế độ ban đêm, đo thời gian sáng và tắt của xung chớp vàng 1 Hz.
• Giai đoạn 5: Bật công tắc tin_hieu_sw(1) = '1' kiểm tra tính năng tạm dừng Pause trong 4 micro giây.
• Giai đoạn 6 & 7: Kích hoạt nút khẩn cấp tin_hieu_key(1) = '0' và tin_hieu_key(2) = '0' để kiểm tra chuyển trạng thái ưu tiên tức thời.
• Kết thúc: Bật cờ ket_thuc_mo_phong <= true để dừng máy phát clock một cách an toàn.

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

Hình 3.1: Toàn cảnh dạng sóng mô phỏng hoàn chỉnh của hệ thống trên ModelSim (Waveform Overview)

• Điểm cần quan sát trên dạng sóng: Dạng sóng toàn cảnh từ lúc bắt đầu Reset, chuyển 4 pha bình thường, kích hoạt chế độ ban đêm, tạm dừng và phản ứng tức thì khi nhấn nút khẩn cấp.

# PHẦN 4: HƯỚNG DẪN THAO TÁC CHỤP ẢNH MODELSIM VÀ CHÈN VÀO BÁO CÁO

Để bản báo cáo đạt điểm tối đa trước Hội đồng chấm thi, bạn thực hiện các bước chụp ảnh dạng sóng từ ModelSim / QuestaSim như sau:

1. Chạy mô phỏng trên ModelSim:
- Trong Quartus, vào Tools -> Run Simulation Tool -> RTL Simulation.
- Cửa sổ ModelSim hiện ra, gõ lệnh: vsim work.tb_traffic_light_top
- Thêm toàn bộ tín hiệu vào dạng sóng: add wave -r /*
- Chạy mô phỏng: run 15 us

2. Định dạng lại các bus tín hiệu cho đẹp mắt:
- Nhấp chuột phải vào các tín hiệu BCD (bcd_a_chuc, bcd_a_don_vi) -> Chọn Radix -> Unsigned Decimal (để hiển thị số thập phân 0, 1, 2,... thay vì mã nhị phân).
- Nhấp chuột phải vào tín hiệu FSM -> Chọn Radix -> Symbolic (để hiển thị tên trạng thái PHA_1, PHA_2,... thay vì số bit).
- Nhấn phím 'F' (Zoom Full) để căn chỉnh toàn bộ dạng sóng vừa khít màn hình.

3. Chụp ảnh và dán vào Word:
- Dùng tổ hợp phím Windows + Shift + S để kéo chụp vùng dạng sóng sắc nét.
- Mở file Word này ra, bấm chuột vào ô khung màu xanh tương ứng ở trên và nhấn Ctrl + V.
- Bấm vào ảnh vừa dán, chọn chế độ căn giữa (Center) để bố cục trang in đạt chuẩn thẩm mỹ cao nhất.

BÁO CÁO GIẢI THÍCH MÃ NGUỒN VHDL & NGUYÊN LÝ HOẠT ĐỘNG CÁC MODULE
