hannagentai-stack/DoAn2_Traffic_Light_FPGA/(commit log)

2026-11-02 feat: complete traffic light system on Cyclone IV (Common Anode & Cathode, UL2803G driver, documentation)
2026-11-02 docs: add comprehensive README with technical specs, pinout and wiring guide
2026-11-05 fix(pinout): synchronize FPGA pin assignments 100% with Altium Designer schematic and PCB
    [generate_pinout_doc.py, traffic_light_top.vhd]
2026-11-11 feat: enhance RTL symmetry & interlock, self-checking testbench, and sync documentation
    - RTL (fsm_controller, traffic_light_top): Add symmetrical KHAN_CAP_B emergency state, expand fail-safe hardware interlock (Green-Green and Green-Yellow conflict protection), and support SIMULATION generic for 7-segment dynamic scanning.
    - SDC (traffic_light_top.sdc): Correct PIN_23 comment to PIN_24 for 50MHz clock.
    - Simulation (tb_traffic_light_top, run_sim.do): Implement 100% self-checking automated assertions across all 7 operational scenarios (0 errors, 0 warnings); support headless batch mode CLI.
    - Hardware & Bitstream (bitstream/traffic_light_top.sof): Recompiled cleanly in Quartus Prime 20.1 (21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
    [fsm_controller.vhd, generate_bom_doc.py, generate_pinout_doc.py, tb_traffic_light_top.vhd, traffic_light_top.vhd]
2026-11-12 fix(fsm): transition KHAN_CAP_B to PHA_3 upon KEY2 release and regenerate bitstreams
    - In fsm_controller.vhd: Releasing KEY2 from KHAN_CAP_B now transitions to PHA_3 (providing full 30s Green for Lane B and pulsing nap_pha) instead of erroneously jumping to PHA_1.
    - In tb_traffic_light_top.vhd: Updated Stage 7 testbench assertion to verify seamless transition to PHA_3; verified 100% pass on ModelSim 2020.1 batch mode.
    - In bitstream/: Recompiled cleanly with Quartus Prime 20.1 (212 LEs, 0 errors, Fmax 178.13 MHz) and regenerated bitstream/traffic_light_top.sof, bitstream/traffic_light_top.jic (EPCS4), and bitstream/traffic_light_top_epcs16.jic (EPCS16).
    - Synchronized all updated source, doc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
    [fsm_controller.vhd, tb_traffic_light_top.vhd]
